nu31hackerspace/space-cow-synth/NU31-HackerSynth.pdf

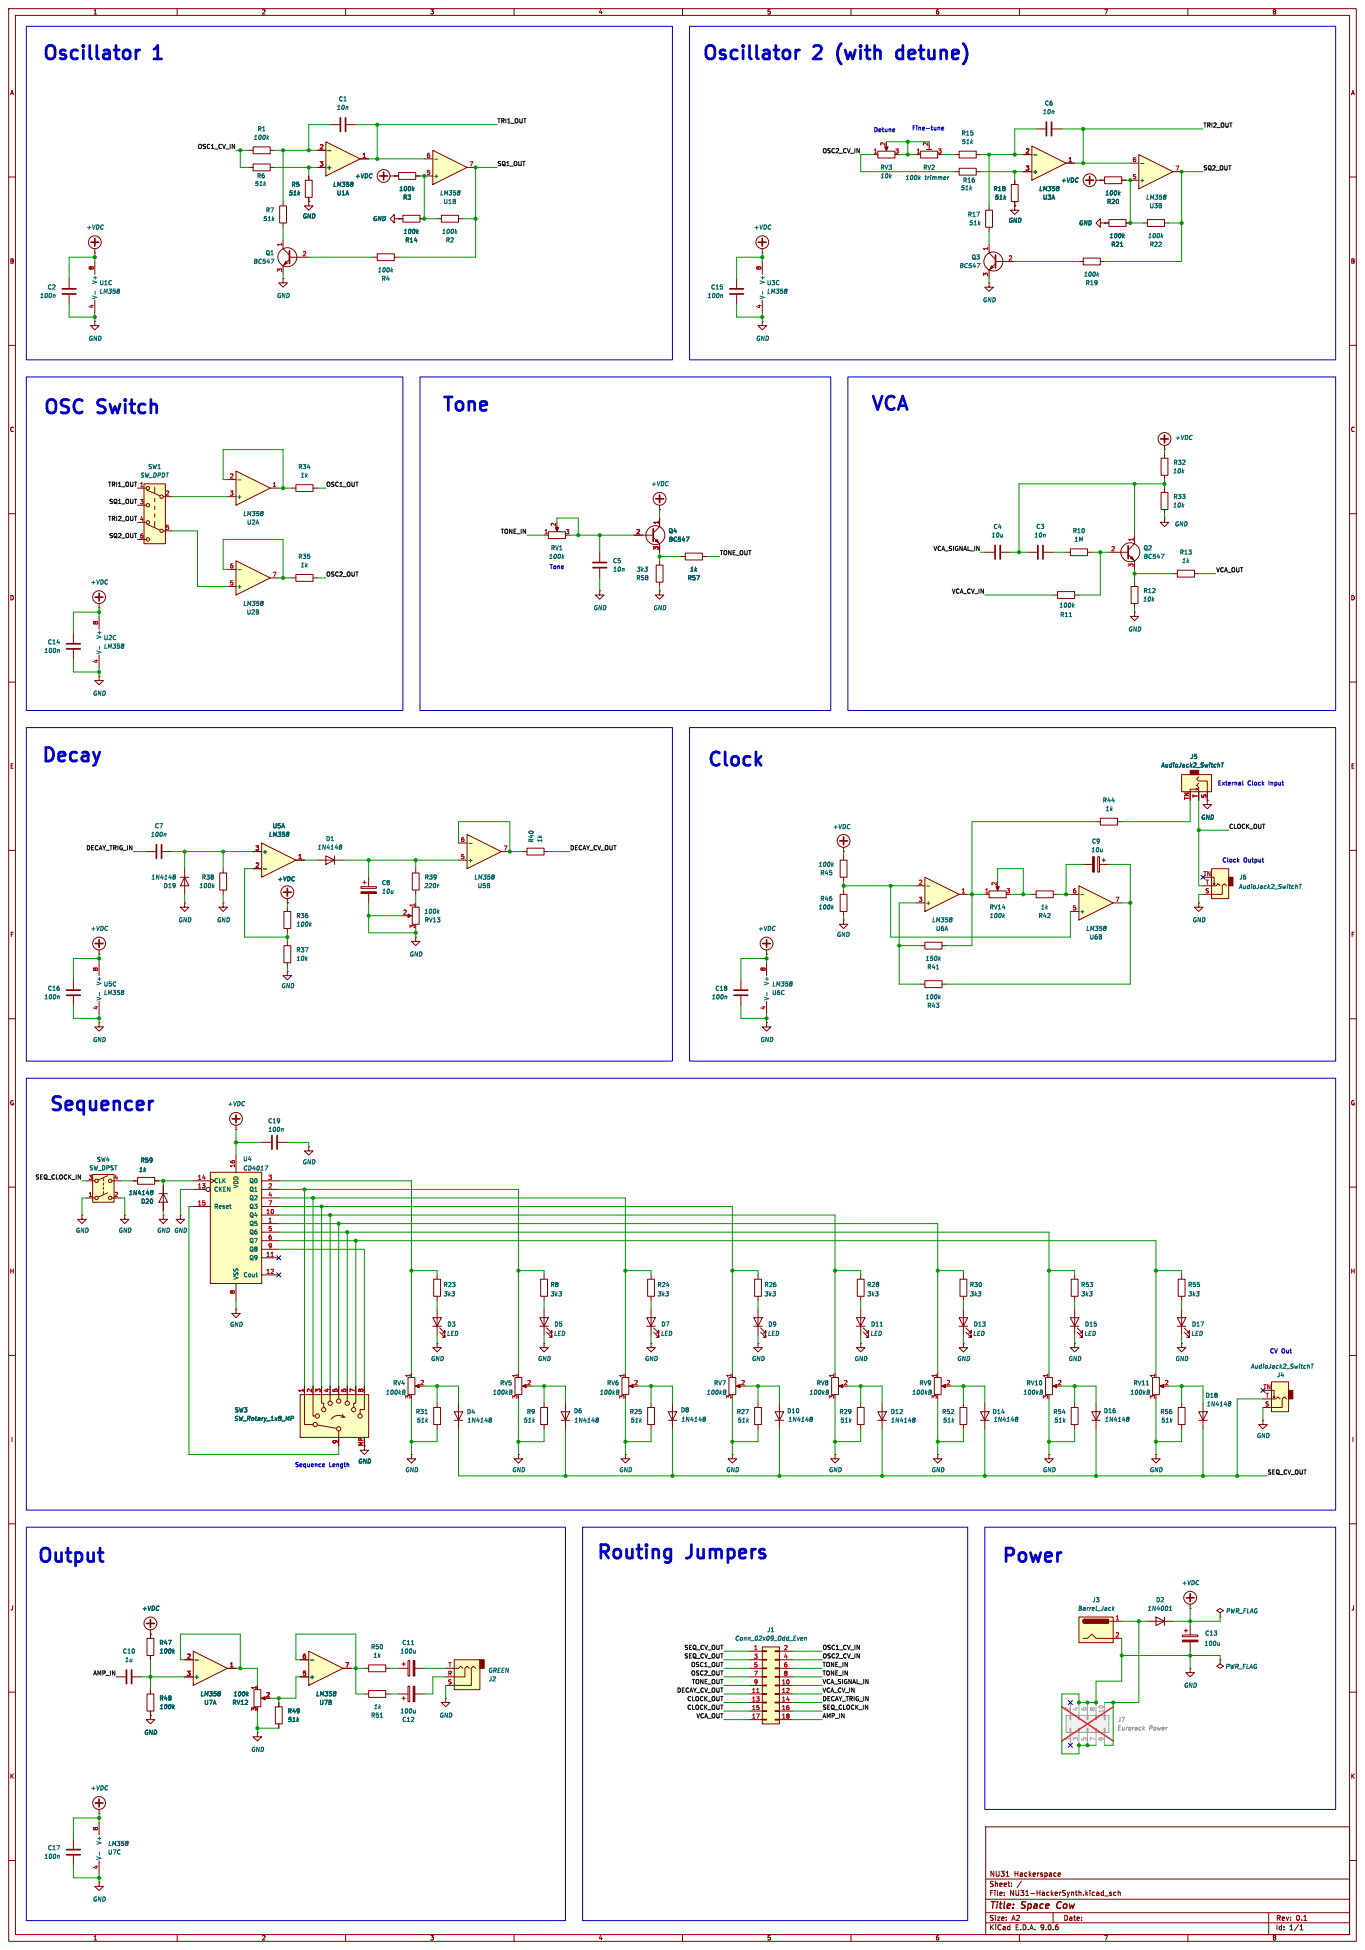
[picture p1: page 1]

Detune Oscillator 2 (with detune)

Id: 1/1 Title: Space Cow
