nu31hackerspace/space-cow-synth/NU31-HackerSynth.kicad_pcb

## KiCad design NU31-HackerSynth.kicad_pcb (2025-11-21)

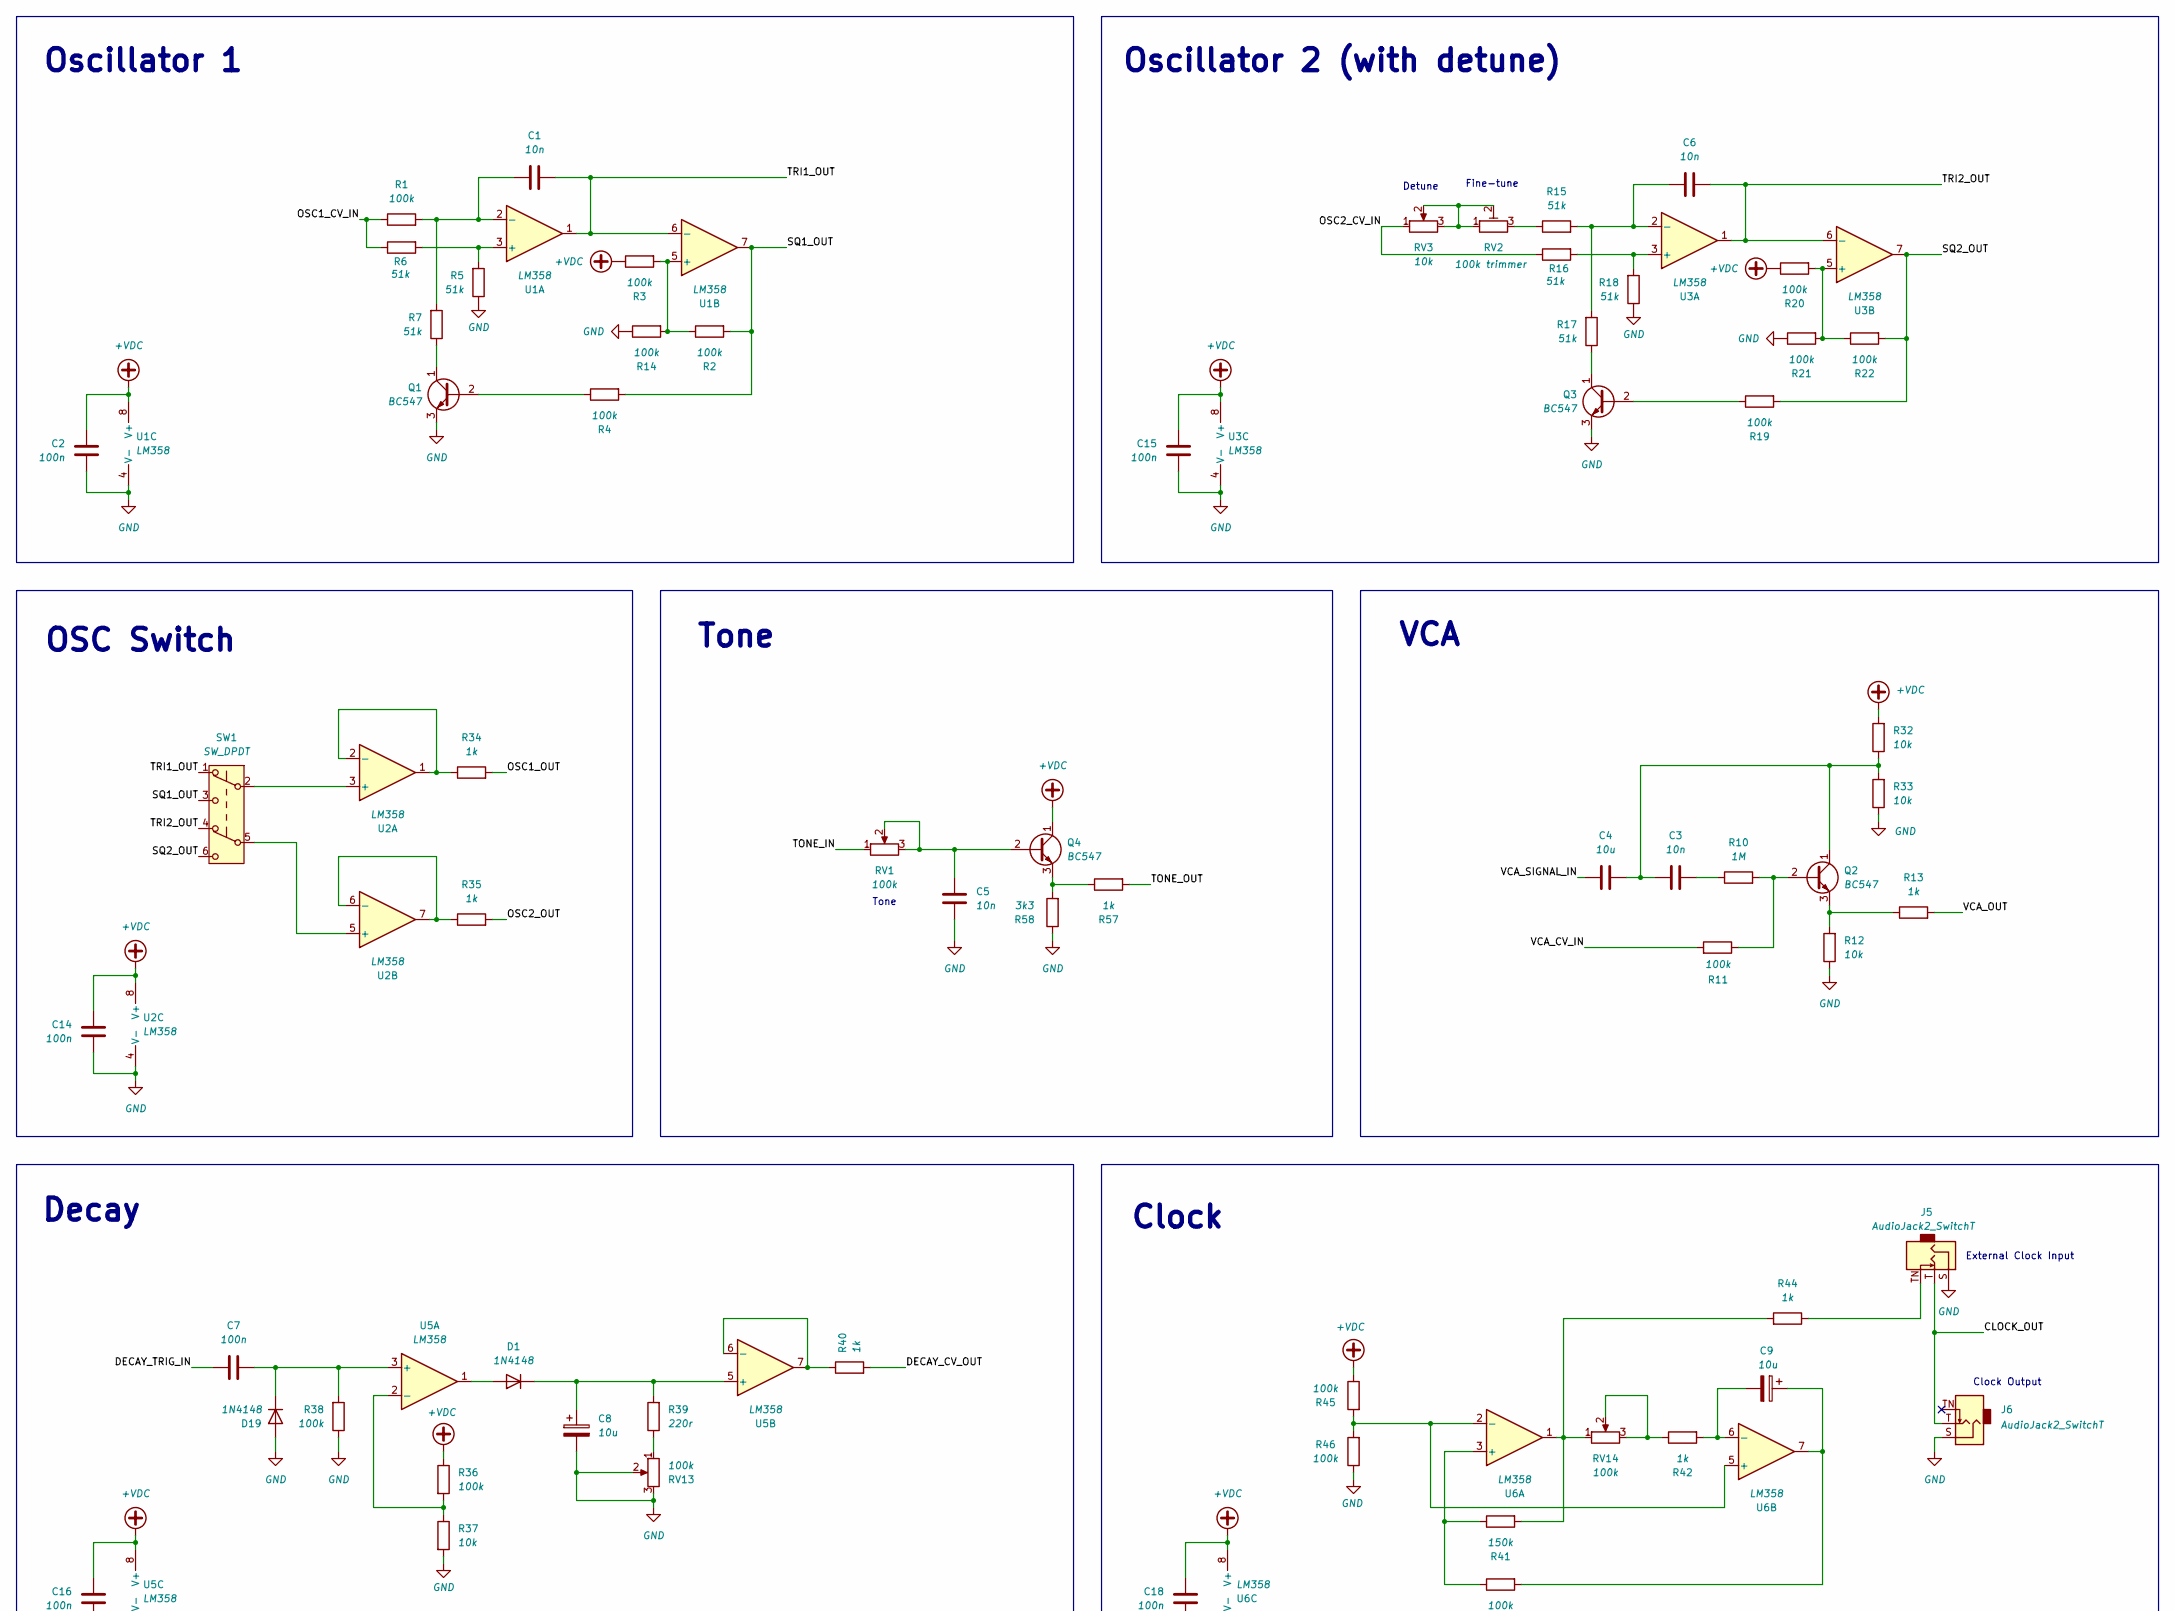
[picture p2: schematic NU31-HackerSynth.kicad_sch, Space Cow, part in row 1, column 1]

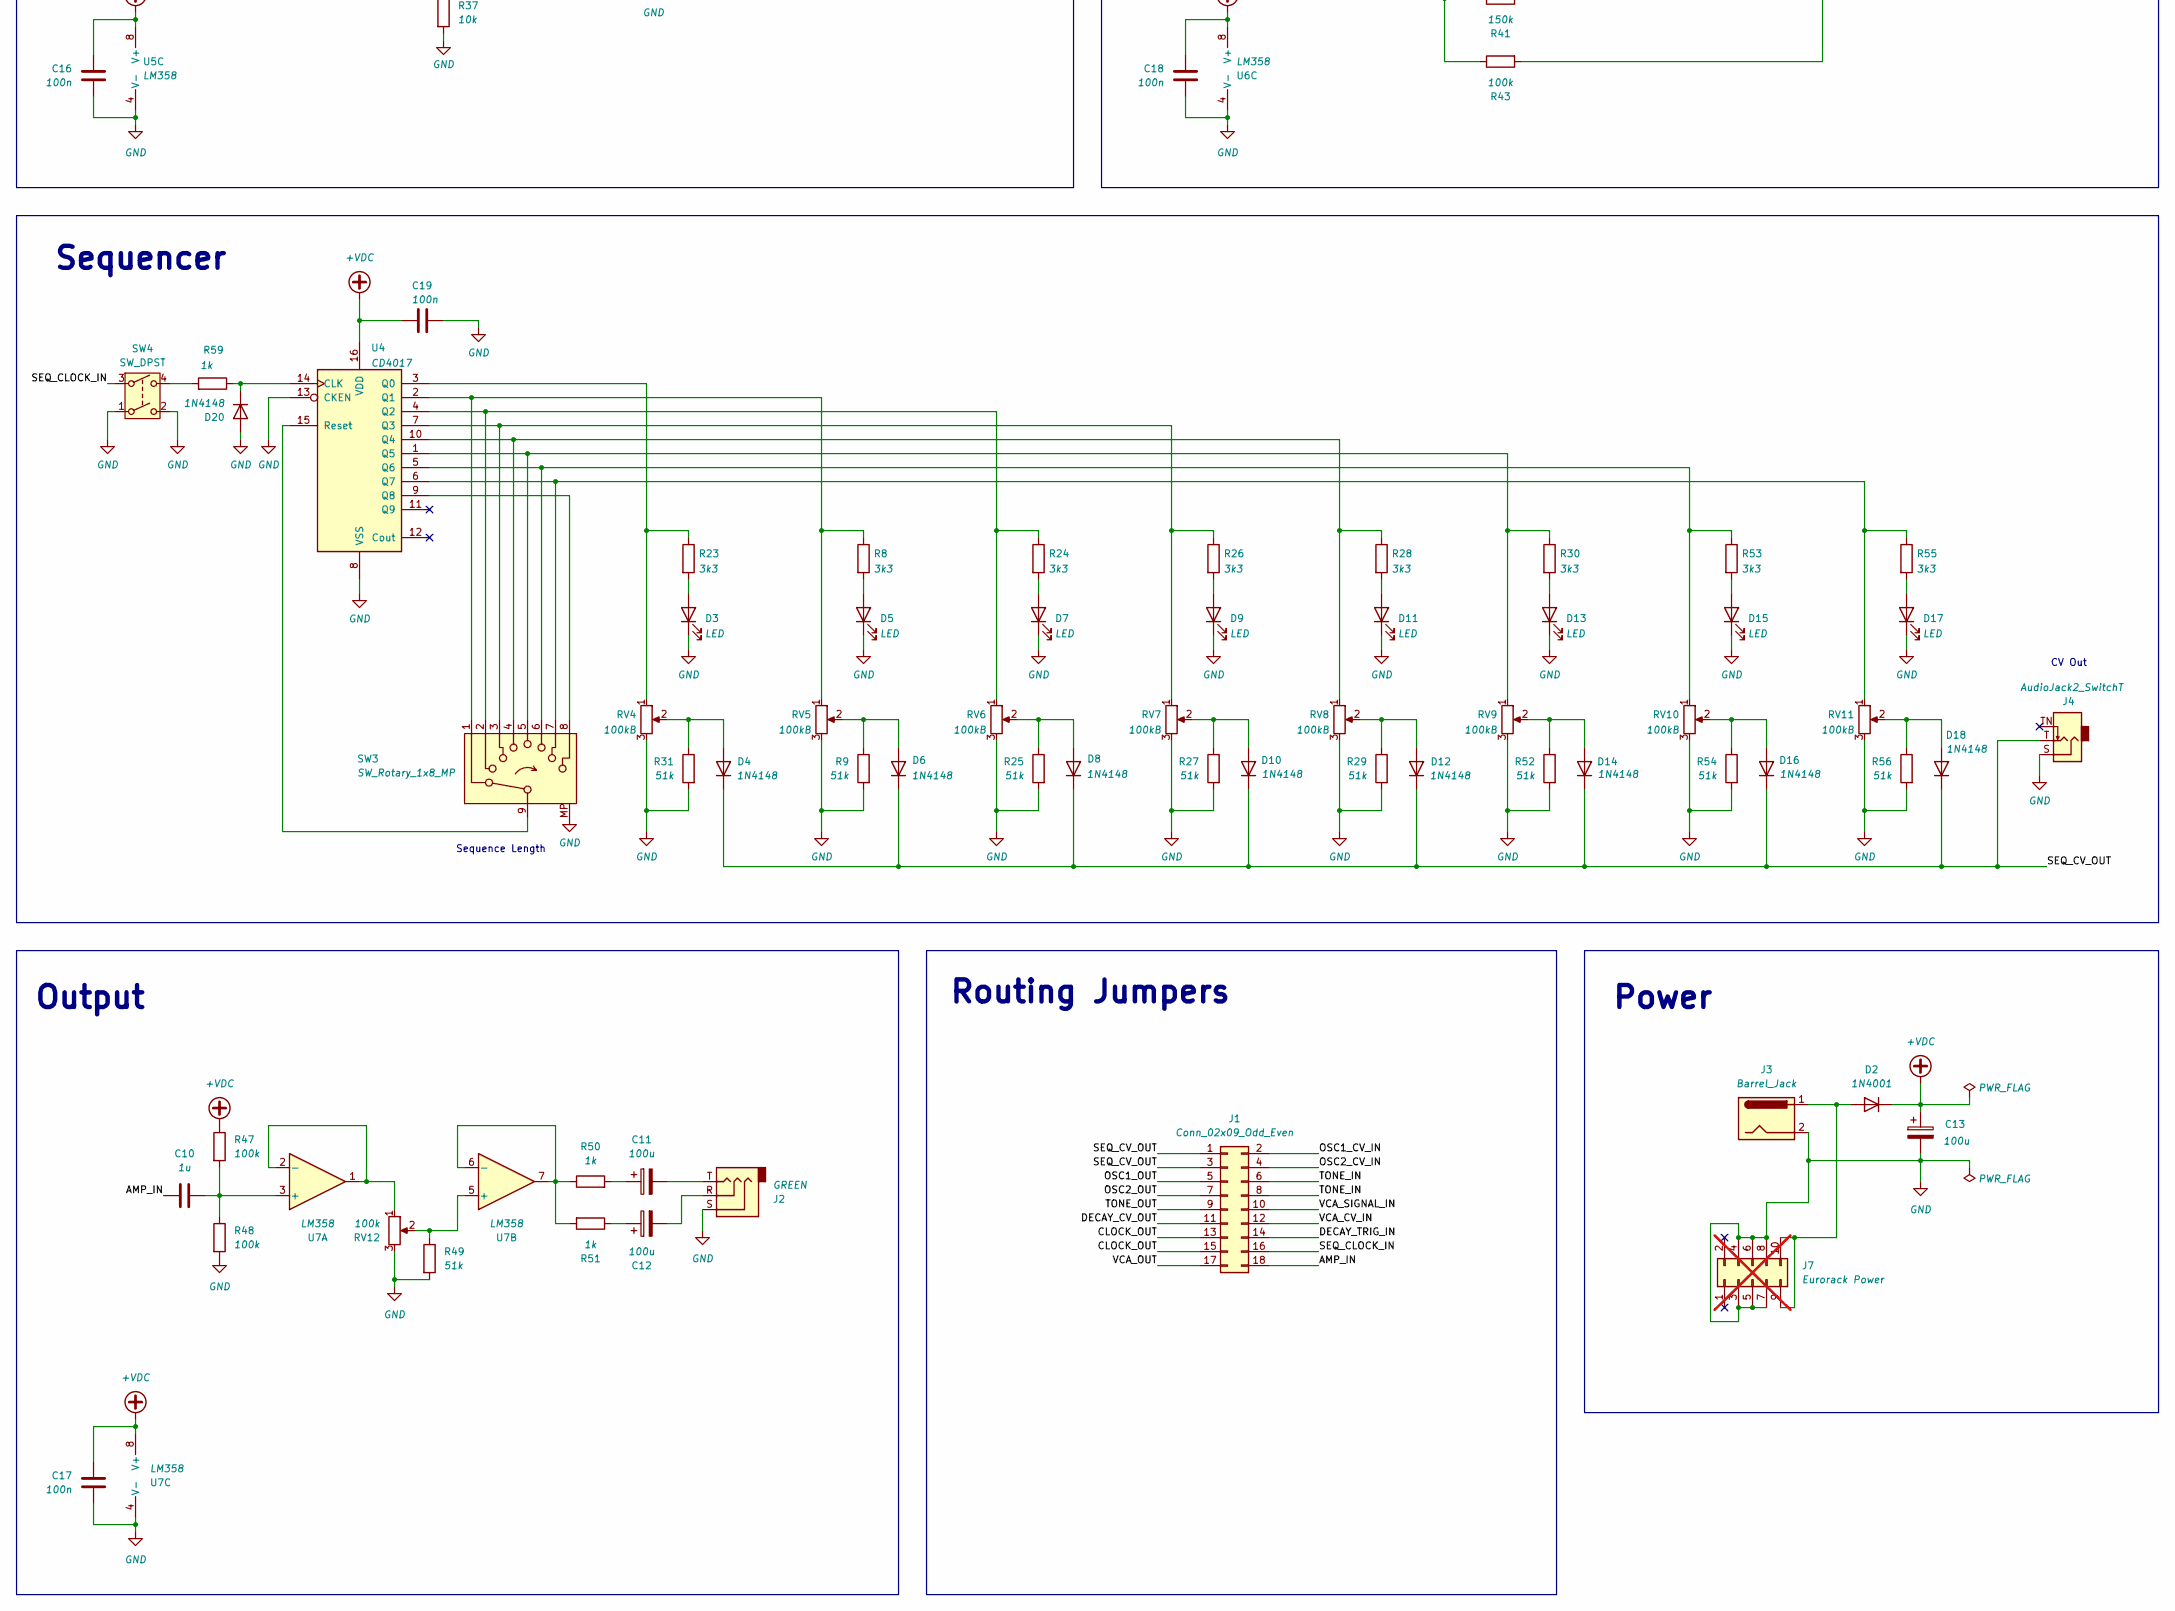
[picture p3: schematic NU31-HackerSynth.kicad_sch, Space Cow, part in row 2, column 1]

Parts:
C1, C3, C5, C6: 10n; C_Disc_D5.1mm_W3.2mm_P5.00mm
C2, C7, C14, C15, C16, C17, C18, C19: 100n; C_Disc_D5.1mm_W3.2mm_P5.00mm
C4: 10u; C_Disc_D5.1mm_W3.2mm_P5.00mm
C8, C9: 10u; CP_Radial_D5.0mm_P2.50mm
C10: 1u; C_Disc_D5.1mm_W3.2mm_P5.00mm
C11, C12, C13: 100u; CP_Radial_D5.0mm_P2.50mm
D1, D4, D6, D8, D10, D12, D14, D16, D18, D19, D20: 1N4148; D_A-405_P7.62mm_Horizontal
D2: 1N4001; D_A-405_P10.16mm_Horizontal
D3, D5, D7, D9, D11, D13, D15, D17: LED; LED_D3.0mm
J1: Conn_02x09_Odd_Even; PinHeader_2x09_P2.54mm_Vertical
J2: GREEN; Jack_3.5mm_QingPu_WQP-PJ366ST_Vertical
J3: Barrel_Jack; BarrelJack_Wuerth_6941xx301002
J4, J5, J6: AudioJack2_SwitchT; Jack_3.5mm_QingPu_WQP-PJ301M-12_Vertical
J7: Eurorack Power; PinSocket_2x05_P2.54mm_Vertical; not fitted
Q1, Q2, Q3, Q4: BC547; TO-92L_Inline_Wide
R1, R2, R3, R4, R11, R14, R19, R20, R21, R22, R36, R38, R43, R45, R46, R47, R48: 100k; R_Axial_DIN0207_L6.3mm_D2.5mm_P10.16mm_Horizontal
R5, R6, R7, R9, R15, R16, R17, R18, R25, R27, R29, R31, R49, R52, R54, R56: 51k; R_Axial_DIN0207_L6.3mm_D2.5mm_P10.16mm_Horizontal
R8, R23, R24, R26, R28, R30, R53, R55, R58: 3k3; R_Axial_DIN0207_L6.3mm_D2.5mm_P10.16mm_Horizontal
R10: 1M; R_Axial_DIN0207_L6.3mm_D2.5mm_P10.16mm_Horizontal
R12, R32, R33, R37: 10k; R_Axial_DIN0207_L6.3mm_D2.5mm_P10.16mm_Horizontal
R13, R34, R35, R40, R42, R44, R50, R51, R57, R59: 1k; R_Axial_DIN0207_L6.3mm_D2.5mm_P10.16mm_Horizontal
R39: 220r; R_Axial_DIN0207_L6.3mm_D2.5mm_P10.16mm_Horizontal
R41: 150k; R_Axial_DIN0207_L6.3mm_D2.5mm_P10.16mm_Horizontal
RV1, RV12, RV13, RV14: 100k; Potentiometer_Alpha_RD901F-40-00D_Single_Vertical
RV2: 100k trimmer; Potentiometer_Bourns_3299P_Horizontal
RV3: 10k; Potentiometer_Alpha_RD901F-40-00D_Single_Vertical
RV4, RV5, RV6, RV7, RV8, RV9, RV10, RV11: 100kB; 40mm Fader Potentiometer (double)
SW1: SW_DPDT; DPDT-subminiature-toggle
SW3: SW_Rotary_1x8_MP; 8-way Rotary Switch
SW4: SW_DPST; 8x8_DPDT_Push_Button
U1, U2, U3, U5, U6, U7: LM358; DIP-8_W7.62mm_Socket
U4: CD4017; DIP-16_W7.62mm_Socket

Connections:
+VDC: C2.1, C13.1, C14.1, C15.1, C16.1, C17.1, C18.1, C19.2, D2.1 (K), Q4.1 (C), R3.1, R20.1, R32.2, R36.1, R45.1, R47.1, U1.8 (V+), U2.8 (V+), U3.8 (V+), U4.16 (VDD), U5.8 (V+), U6.8 (V+), U7.8 (V+)
/AMP_IN: C10.1, J1.18
/CLOCK_OUT: J1.13, J1.15, J5.T, J6.T
/DECAY_CV_OUT: J1.11, R40.2
/DECAY_TRIG_IN: C7.1, J1.14
/OSC1_CV_IN: J1.2, R1.1, R6.1
/OSC1_OUT: J1.5, R34.2
/OSC2_CV_IN: J1.4, R16.1, RV3.1
/OSC2_OUT: J1.7, R35.2
/SEQ_CLOCK_IN: J1.16, SW4.3
/SEQ_CV_OUT: D4.1 (K), D6.1 (K), D8.1 (K), D10.1 (K), D12.1 (K), D14.1 (K), D16.1 (K), D18.1 (K), J1.1, J1.3, J4.T
/SQ1_OUT: R2.2, R4.2, SW1.3 (C), U1.7
/SQ2_OUT: R19.2, R22.2, SW1.6 (C), U3.7
/TONE_IN: J1.6, J1.8, RV1.1
/TONE_OUT: J1.9, R57.2
/TRI1_OUT: C1.2, SW1.1 (A), U1.1, U1.6 (-)
/TRI2_OUT: C6.2, SW1.4 (A), U3.1, U3.6 (-)
/VCA_CV_IN: J1.12, R11.2
/VCA_OUT: J1.17, R13.2
/VCA_SIGNAL_IN: C4.1, J1.10
GND: C2.2, C5.2, C8.2, C13.2, C14.2, C15.2, C16.2, C17.2, C18.2, C19.1, D3.1 (K), D5.1 (K), D7.1 (K), D9.1 (K), D11.1 (K), D13.1 (K), D15.1 (K), D17.1 (K), D19.2 (A), D20.2 (A), J2.S, J3.2, J4.S, J5.S, J6.S, J7.3, J7.4, J7.5, J7.6, J7.7, J7.8, Q1.3 (E), Q3.3 (E), R5.1, R9.2, R12.1, R14.1, R18.1, R21.1, R25.2, R27.2, R29.2, R31.2, R33.1, R37.2, R38.1, R46.1, R48.2, R49.2, R52.2, R54.2, R56.2, R58.1, RV4.3, RV5.3, RV6.3, RV7.3, RV8.3, RV9.3, RV10.3, RV11.3, RV12.3, RV13.2, RV13.3, SW3.MP, SW4.1, SW4.2, U1.4 (V-), U2.4 (V-), U3.4 (V-), U4.8 (VSS), U4.13 (CKEN), U5.4 (V-), U6.4 (V-), U7.4 (V-)
unnamed: C3.2, R10.1
unnamed: C9.1, R43.2, U6.7
unnamed: C11.1, R50.2
unnamed: C11.2, J2.T
unnamed: C12.1, R51.1
unnamed: C12.2, J2.R
unnamed: D1.2 (A), U5.1
unnamed: C8.1, D1.1 (K), R39.2, U5.5 (+)
unnamed: D2.2 (A), J3.1, J7.9, J7.10
unnamed: D3.2 (A), R23.2
unnamed: D4.2 (A), R31.1, RV4.2
unnamed: D5.2 (A), R8.2
unnamed: D6.2 (A), R9.1, RV5.2
unnamed: D7.2 (A), R24.2
unnamed: D8.2 (A), R25.1, RV6.2
unnamed: D9.2 (A), R26.2
unnamed: D10.2 (A), R27.1, RV7.2
unnamed: D11.2 (A), R28.2
unnamed: D12.2 (A), R29.1, RV8.2
unnamed: D13.2 (A), R30.2
unnamed: D14.2 (A), R52.1, RV9.2
unnamed: D15.2 (A), R53.2
unnamed: D16.2 (A), R54.1, RV10.2
unnamed: D17.2 (A), R55.2
unnamed: D18.2 (A), R56.1, RV11.2
unnamed: C7.2, D19.1 (K), R38.2, U5.3 (+)
unnamed: D20.1 (K), R59.1, U4.14 (CLK)
unnamed: J5.TN, R44.1
unnamed: Q1.2 (B), R4.1
unnamed: Q1.1 (C), R7.1
unnamed: Q2.2 (B), R10.2, R11.1
unnamed: C3.1, C4.2, Q2.1 (C), R32.1, R33.2
unnamed: Q2.3 (E), R12.2, R13.1
unnamed: Q3.2 (B), R19.1
unnamed: Q3.1 (C), R17.1
unnamed: C5.1, Q4.2 (B), RV1.2, RV1.3
unnamed: Q4.3 (E), R57.1, R58.2
unnamed: R15.1, RV2.3
unnamed: R39.1, RV13.1
unnamed: R41.2, R44.2, RV14.1, U6.1
unnamed: R42.1, RV14.2, RV14.3
unnamed: R59.2, SW4.4
unnamed: RV2.1, RV2.2, RV3.2, RV3.3
unnamed: R5.2, R6.2, U1.3 (+)
unnamed: C1.1, R1.2, R7.2, U1.2 (-)
unnamed: R2.1, R3.2, R14.2, U1.5 (+)
unnamed: SW1.2 (B), U2.3 (+)
unnamed: R34.1, U2.1, U2.2 (-)
unnamed: SW1.5 (B), U2.5 (+)
unnamed: R35.1, U2.6 (-), U2.7
unnamed: R16.2, R18.2, U3.3 (+)
unnamed: C6.1, R15.2, R17.2, U3.2 (-)
unnamed: R20.2, R21.2, R22.1, U3.5 (+)
unnamed: R23.1, RV4.1, U4.3 (Q0)
unnamed: R8.1, RV5.1, SW3.1, U4.2 (Q1)
unnamed: R24.1, RV6.1, SW3.2, U4.4 (Q2)
unnamed: R26.1, RV7.1, SW3.3, U4.7 (Q3)
unnamed: R28.1, RV8.1, SW3.4, U4.10 (Q4)
unnamed: R30.1, RV9.1, SW3.5, U4.1 (Q5)
unnamed: R53.1, RV10.1, SW3.6, U4.5 (Q6)
unnamed: R55.1, RV11.1, SW3.7, U4.6 (Q7)
unnamed: SW3.8, U4.9 (Q8)
unnamed: SW3.9, U4.15 (Reset)
unnamed: R36.2, R37.1, U5.2 (-)
unnamed: R40.1, U5.6 (-), U5.7
unnamed: R41.1, R43.1, U6.3 (+)
unnamed: R45.2, R46.2, U6.2 (-), U6.5 (+)
unnamed: C9.2, R42.2, U6.6 (-)
unnamed: C10.2, R47.2, R48.1, U7.3 (+)
unnamed: RV12.1, U7.1, U7.2 (-)
unnamed: R49.1, RV12.2, U7.5 (+)
unnamed: R50.1, R51.2, U7.6 (-), U7.7

Notes on the sheet:
Sequencer
VCA
Oscillator 2 (with detune)
CV Out
Fine-tune
Power
Clock Output
Sequence Length
Tone
Routing Jumpers
Decay
External Clock Input
Output
Oscillator 1
OSC Switch
Detune
Clock

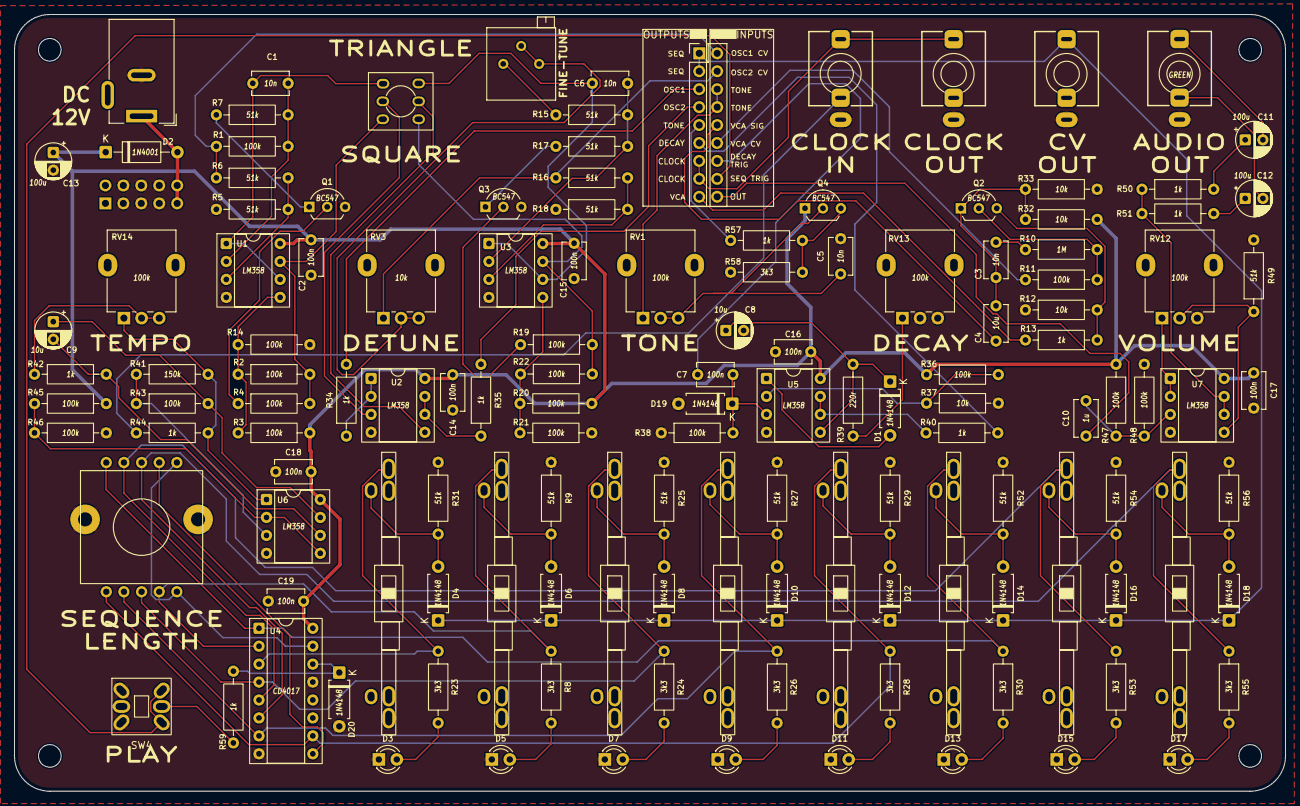
[picture p4: board NU31-HackerSynth.kicad_pcb from above]

Board: 2 copper layers, 180.0 x 110.0 mm, 133 parts (1 on the bottom side), 93 nets.
