nu31hackerspace/space-cow-synth/(commit log)

2025-08-31 Updated schematics layout, added clock input and output jacks and CV output jack, changed sequence length jumper pins from 7x2 to 8x2 (2 pins unconnected, just to keep the jumper)
    [NU31-HackerSynth.kicad_sch]
2025-08-31 Grounded CKEN and CLK switch, switched diodes in sequencer to 1N4148
    [NU31-HackerSynth.kicad_sch]
2025-08-31 Added buffer to mixer output, connected last step reset jumper pins
    [NU31-HackerSynth.kicad_sch]
2025-09-04 added schematics PDF
2025-09-04 Added eurorack power connector, assigned the footprints and made a (very) draft layout of the board
    [NU31-HackerSynth.kicad_pcb, NU31-HackerSynth.kicad_sch]
2025-09-04 Replaced sequence length jumper pins with 8-position switch
    [NU31-HackerSynth.kicad_sch]
2025-09-04 updated PDF schematic
2025-09-04 Added diode to filter out negatvie voltages in decay circuit input
    [NU31-HackerSynth.kicad_sch]
2025-09-06 Updated and separated OSC type switch and tone control into separate blocks
    [NU31-HackerSynth.kicad_sch]
2025-09-19 Added negative voltage protection for sequencer clock input, added footprints for faders and rotaryswitch
    [NU31-HackerSynth.kicad_pcb, NU31-HackerSynth.kicad_sch]
2025-09-20 added decoupling cap for CD4017, replaced all routing jumpers with one pin header
    [NU31-HackerSynth.kicad_pcb, NU31-HackerSynth.kicad_sch]
2025-09-25 Changed slider-switches to push-button and toggle switch, renamed mixer pins to tone
    [NU31-HackerSynth.kicad_pcb, NU31-HackerSynth.kicad_sch]
2025-09-26 Board layout is ready. Also fixed some wrong polarity issues in the schematics
    [NU31-HackerSynth.kicad_pcb, NU31-HackerSynth.kicad_sch]
2025-09-26 Updated pdf schematics
2025-09-26 Changed VCC trace width to 0.5mm, changed clearence to 0.2
    [NU31-HackerSynth.kicad_pcb]
2025-09-26 Updated OSC shape switch footprint, optimized routing for decoupling capacitors and ground plane
    [NU31-HackerSynth.kicad_pcb, NU31-HackerSynth.kicad_sch]
2025-09-26 tidied up capacitor values on silkscreen
    [NU31-HackerSynth.kicad_pcb]
2025-09-28 removed stray part of the trace
    [NU31-HackerSynth.kicad_pcb]
2025-10-19 fixed clock switch pinout and footprint
    [NU31-HackerSynth.kicad_pcb, NU31-HackerSynth.kicad_sch]
2025-11-12 Fine-tuned the value, fixed power polarity in the schematics
    [NU31-HackerSynth.kicad_sch]
2025-11-21 updated fader footprint, fixed DC barrel polarity in the layout
    [NU31-HackerSynth.kicad_pcb]
